hPeterPan/MP3_Player/MP3_Player.pdf

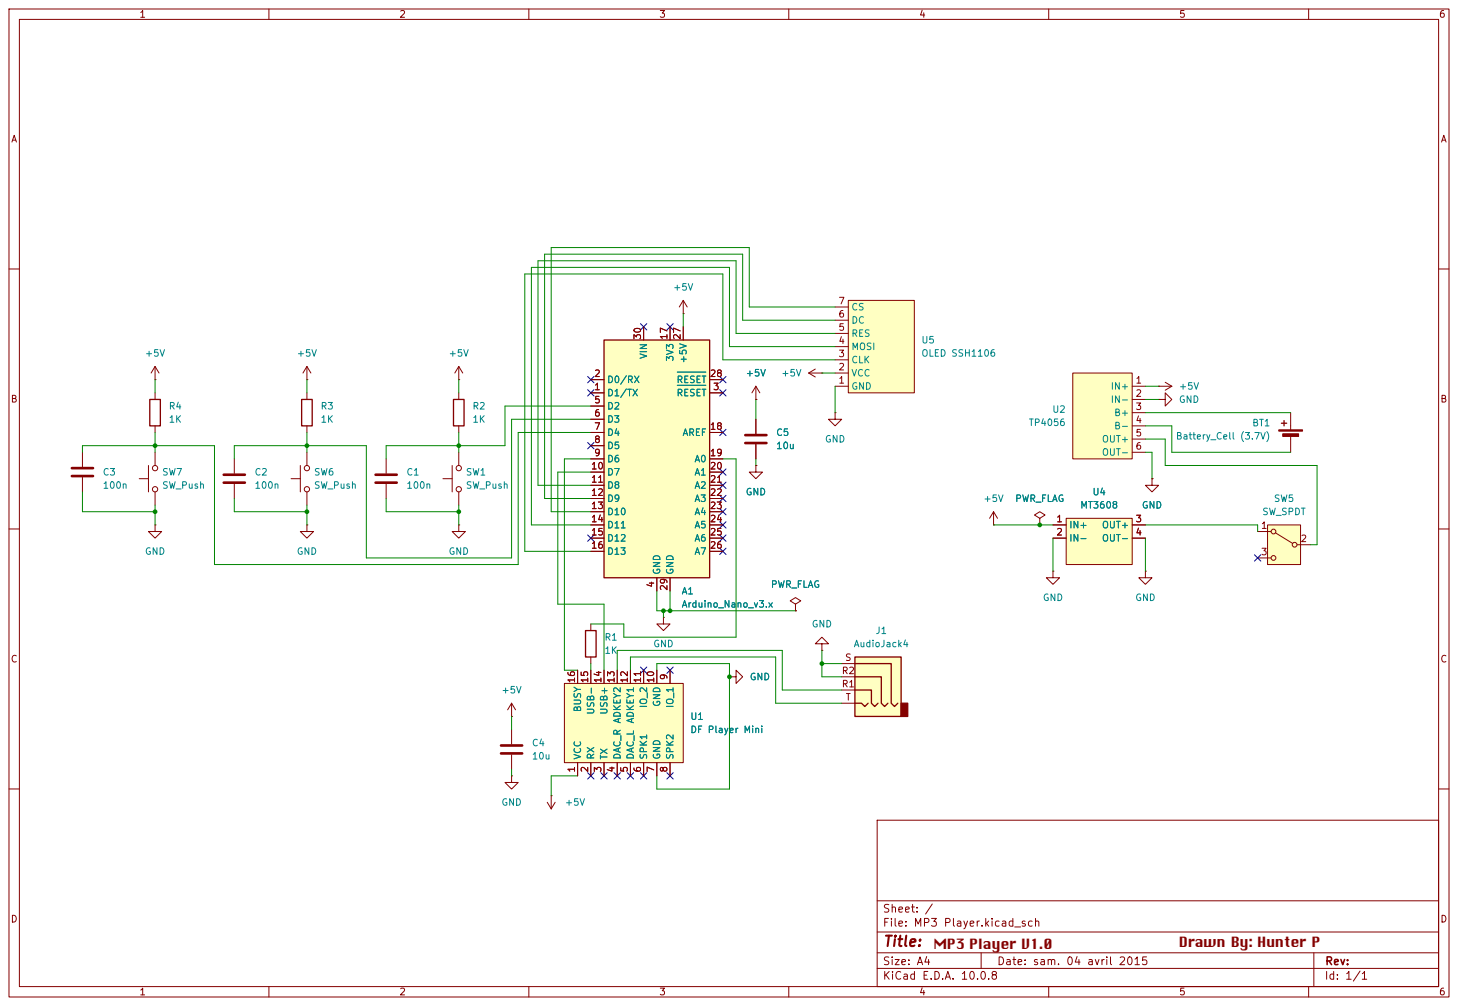
[picture p3: page 1]

9 GND 10 IO_2 11 ADKEY1 12 ADKEY2 13 USB+ 14 USB- 15 BUSY 16 U1DF Player Mini C4

9 GND 10 IO_2 11 ADKEY1 12 ADKEY2 13 USB+ 14 USB- 15 BUSY 16

Size: A4 | Rev:
KiCad E.D.A. 10.0.8 | Id: 1/1
